phorton1/Arduino-tempController/docs/readme.md

# tempearature Controller

This is an ESP32 based Relay controller based on a **DS18B20** temperature
sensors.

## Please Also See

This project directly makes direct use of my
[**MyIOT**](https://github.com/phorton1/Arduino-libraries-myIOT)
("my internet of things*) repository, which provides a generalized approach to
building relatively simple parameter driven ESP32 devices that include a Web UI.

The PCBs (printed circuit boards) were **milled** using the
[**cnc3018**](https://github.com/phorton1/Arduino-esp32_cnc3018) CNC
machine that I built.

I hope you will take a few minutes to check out some of these other pages too!!

## Credits

This project directly relies upon the public open source Arduino development system,
the Espressif ESP32 online documentation and additions to the Arduino IDE, as
well as a number open source Arduino libraries

I would like to thank the countless individuals who have contributed to making these
development tools, source codes, and documentation available for free public use, including,
but not limited to:

- [KiCad](https://www.kicad.org/)
- [FlatCAM](https://bitbucket.org/jpcgt/flatcam/downloads/) by **Juan Pablo Caram**
- [Arduino IDE and Libraries](https://www.arduino.cc/)
- [Espressif Systems](https://www.espressif.com/en/products/socs/esp32)
- **jQuery**, **Bootstrap**, and the [jqPlot](Xhttp://www.jqplot.com/) javascript libraries

## License

This program, project, and repository is free software: you can redistribute it and/or modify
it under the terms of the GNU General Public License Version 3 as published by
the Free Software Foundation.

These materials are distributed in the hope that they will be useful,
but WITHOUT ANY WARRANTY; without even the implied warranty of
MERCHANTABILITY or FITNESS FOR ANY PARTICULAR PURPOSE.  See the
GNU General Public License for more details.

Please see [LICENSE.TXT](../LICENSE.TXT) for more information.
