phorton1/Arduino-tempController/docs/fusion/temp_box_top.stl

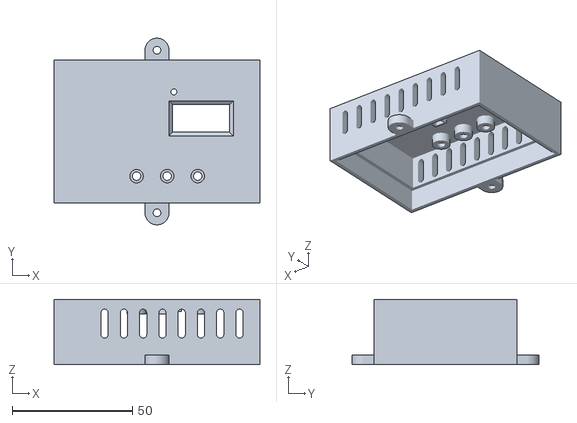
[picture p1: CAD file, 2024-12-26]
docs/fusion/temp_box_top.stl
85.5 x 77.5 x 27.0
