phorton1/Arduino-tempController/docs/fusion/temp_box_button_cap.stl

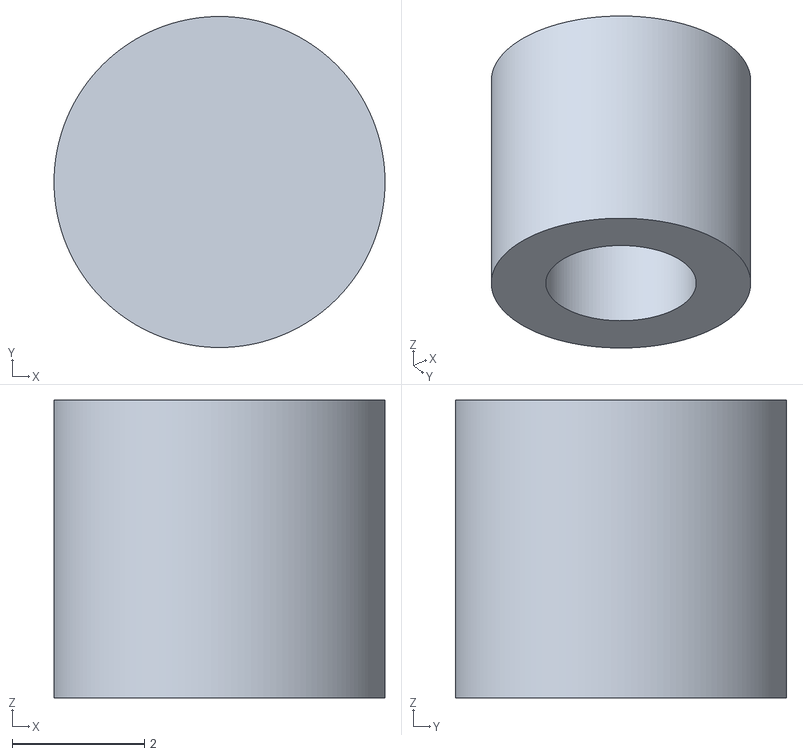
[picture p2: CAD file, 2024-12-26]
docs/fusion/temp_box_button_cap.stl
5.00 x 5.00 x 4.50
