phorton1/Arduino-tempController/docs/prusa/temp_box_button_caps.3mf

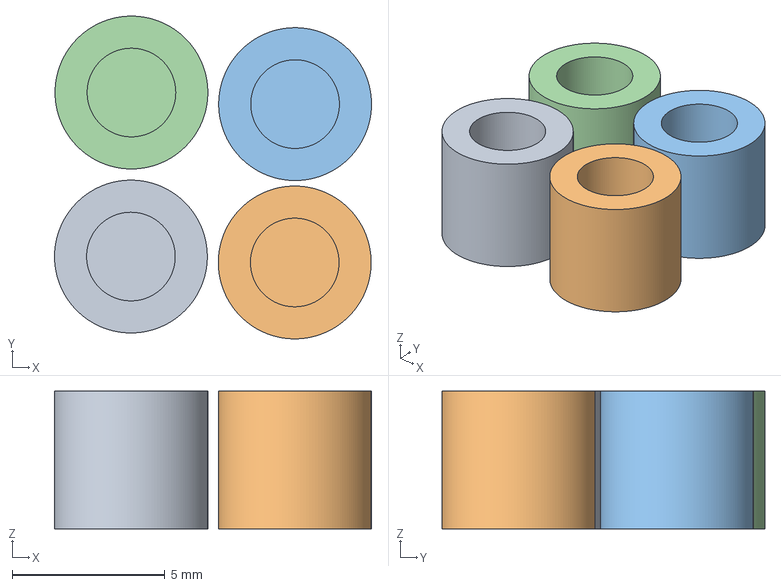
[picture p3: CAD file, 2024-12-26]
docs/prusa/temp_box_button_caps.3mf
10.4 x 10.6 x 4.50 mm
temp_box_button_cap.stl x 4
