phorton1/Arduino-tempController/docs/fusion/temp_box_base.stl

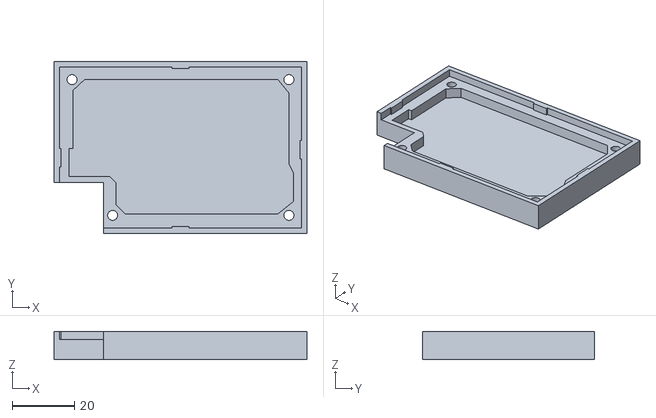
[picture p4: CAD file, 2024-12-26]
docs/fusion/temp_box_base.stl
81.1 x 55.1 x 9.00
