phorton1/Arduino-tempController/(list of files, cad)

Other CAD files:
docs/prusa/temp_box_top.3mf
docs/prusa/temp_box_base.3mf
docs/fusion/tempControllerBox.f3d
