phorton1/Arduino-tempController/docs/kicad/board/board.kicad_pcb

## KiCad design docs/kicad/board/board.kicad_pcb (2024-12-26)

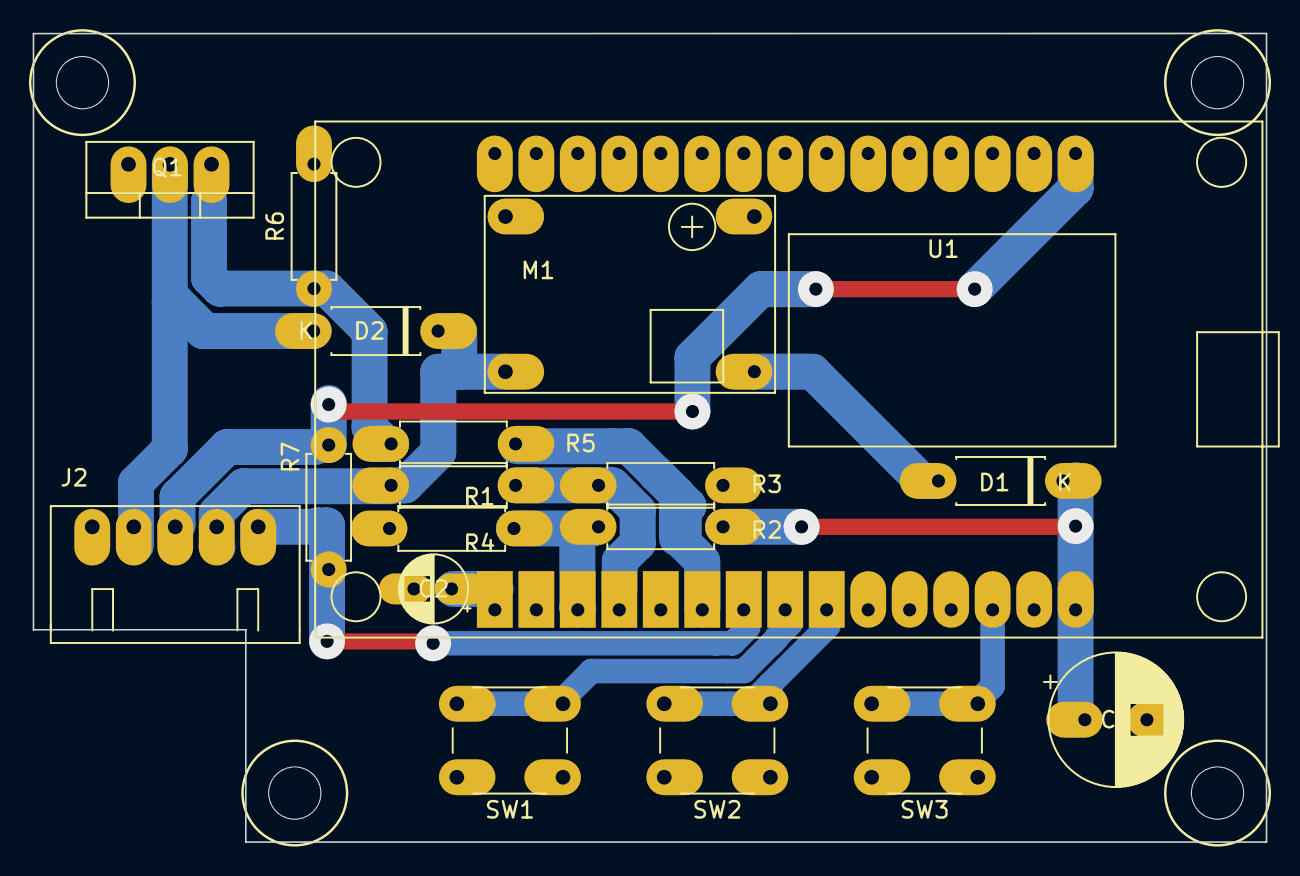
[picture p5: board board.kicad_pcb from above]

Board: 2 copper layers, 75.5 x 49.5 mm, 18 parts (0 on the bottom side), 15 nets.

Parts:
C1: 100uf; CP_my100uf
C2: 4.7uf; CP_my10uf
D1: 1N4005; myDiodeSchotsky
D2: 1N5818; myDiodeSchotsky
J2: Connector; myJST5_right
M1: BUCK01; buck-mini360
Q1: IRLZ44N; myThreeLeggedDown
R1: 10K; resistor
R2, R4, R7: 4.7K; resistor
R3: 2K; resistor
R5: 100; resistor
R6: 10K; myResistor
SW1: BUTTON1; button_6mm_H8
SW2: BUTTON2; button_6mm_H8
SW3: BUTTON3; button_6mm_H8
U1: ESP32_DEV_0; esp32_oled_small

Connections:
+3V3: J2.3, R7.2, U1.30
+5V: C1.1, D1.1, R2.2, U1.1
+12V: D2.1, J2.4, M1.4, R1.2
BUTTON1: SW1.2, U1.8
BUTTON2: SW2.2, U1.7
BUTTON3: SW3.2, U1.3
EN: C2.1, U1.15
FAN-: D2.2, J2.2, Q1.2
GND: C1.2, C2.2, J2.1, M1.1, M1.2, Q1.3, R3.1, R4.1, R6.2, SW1.1, SW2.1, SW3.1, U1.2, U1.29
unnamed: D1.2, M1.3
unnamed: Q1.1, R5.2, R6.1
ONE_WIRE: J2.5, R7.1, U1.9
RELAY: R5.1, U1.10
S_5V: R2.1, R4.2, U1.13
S_12V: R1.1, R3.2, U1.12
