phorton1/Arduino-tempController/docs/kicad/connector_pcb/connector_pcb.kicad_pcb

## KiCad design docs/kicad/connector_pcb/connector_pcb.kicad_pcb (2024-12-11)

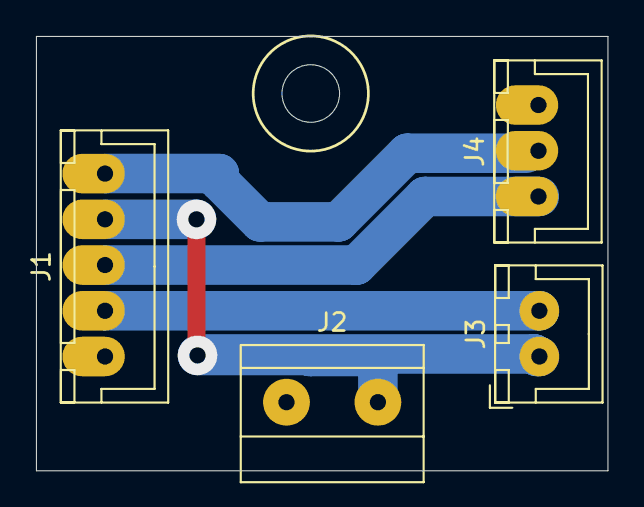
[picture p6: board connector_pcb.kicad_pcb from above]

Board: 2 copper layers, 31.8 x 24.1 mm, 4 parts (0 on the bottom side), 5 nets.

Parts:
J1: Connector; JST5
J2: POWER; myTerminalBlock_5.08x02
J3: FAN; myJSTx02
J4: TEMP; JST3

Connections:
+3V3: J1.3, J4.1
+12V: J1.4, J2.2, J3.1
FAN-: J1.2, J3.2
GND: J1.1, J2.1, J4.3
ONE_WIRE: J1.5, J4.2
