phorton1/Arduino-tempController/docs/kicad/board1/board1.kicad_pcb

## KiCad design docs/kicad/board1/board1.kicad_pcb (2024-10-21)

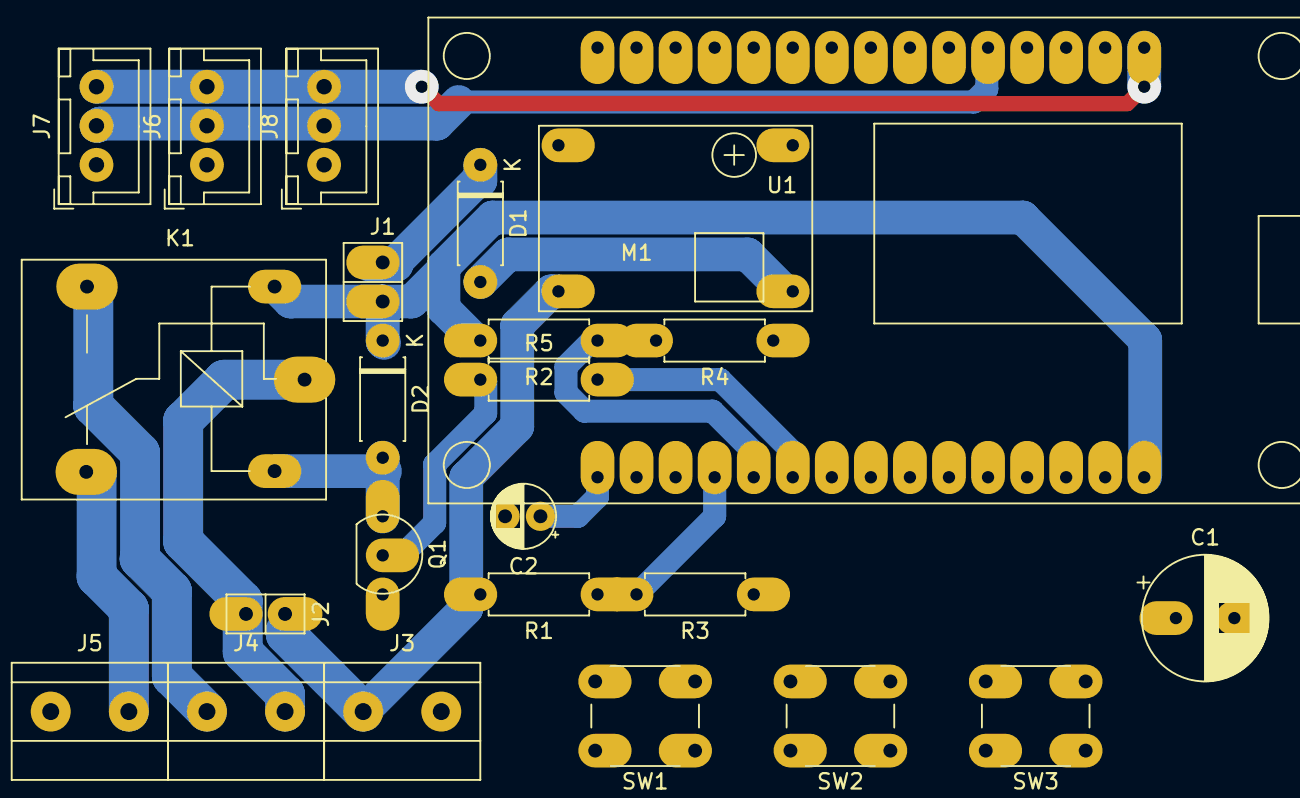
[picture p7: board board1.kicad_pcb from above]

Board: 2 copper layers, 24 parts (0 on the bottom side), 19 nets.

Parts:
C1: 100uf; CP_my100uf
C2: 4.7uf; CP_my10uf
D1, D2: 1N400x; myDiodeSchotsky
J1: 5V_JUMP; pinHeader1x2
J2: 12V; myPinHeader_1x02
J3: POWER; myTerminalBlock_5.08x02
J4: RELAY; myTerminalBlock_5.08x02
J5: DEVICE; myTerminalBlock_5.08x02
J6, J7, J8: Temp; myJSTx03
K1: myRelay; myRelay2
M1: BUCK01; buck-mini360
Q1: BCS547; transistor
R1, R2: 10K; resistor
R3: 2K; resistor
R4: 4.7K; resistor
R5: 1K; resistor
SW1: BUTTON1; button_6mm_H12
SW2: BUTTON2; button_6mm_H12
SW3: BUTTON3; button_6mm_H12
U1: ESP32_DEV_0; esp32_oled_small

Connections:
+3V3: J6.3, J7.3, J8.3, U1.30
+5V: C1.1, D2.1, J1.2, K1.2, R2.2, U1.1
+12V: J2.1, J3.1, M1.4, R1.2
BUTTON1: SW1.2, U1.5
BUTTON2: SW2.2, U1.4
BUTTON3: SW3.2, U1.3
COMMON: J2.2, J4.2, K1.3
GND: C1.2, C2.2, J3.2, J5.1, J6.1, J7.1, J8.1, M1.1, M1.2, Q1.3, R3.1, R4.1, SW1.1, SW2.1, SW3.1, U1.2, U1.29
NC: J5.2, K1.4
NO: J4.1, K1.5
unnamed: C2.1, U1.15
unnamed: D1.1, J1.1
unnamed: D1.2, M1.3
unnamed: D2.2, K1.1, Q1.1
unnamed: Q1.2, R5.1
ONE_WIRE: J6.2, J7.2, J8.2, U1.26
RELAY: R5.2, U1.10
S_5V: R2.1, R4.2, U1.11
S_12V: R1.1, R3.2, U1.12
