phorton1/Arduino-tempController/controller.h

//----------------------------------------------
// constants for temperature controller
//----------------------------------------------
// Embedded SSD1306 display uses ESP32 standard I2C scl(22) sda(21)

#pragma once

#include <myIOTDevice.h>

#define WITH_ONBOARD_LED	1
	// shows blue if !wifi STATION


//=========================================================
// pins
//=========================================================

#define PIN_ONBOARD_LED		2
#define PIN_ONE_WIRE		33		// One-Wire bus to DS18B20 temperature probes

#define PIN_BUTTON1			25
#define PIN_BUTTON2			26
#define PIN_BUTTON3			13

#define PIN_S_12V			34		// sense 12V
#define PIN_S_5V			39		// sense buck 5V power supply

#define PIN_RELAY			32		// Actually, a MOSFET turns FAN on


//------------------------
// myIOT definition
//------------------------

#define TEMP_CONTROLLER			"tempController"
#define TEMP_CONTROLLER_VERSION	"tc0.1"
#define TEMP_CONTROLLER_URL		"https://github.com/phorton1/Arduino-boat-tempController"

#define BACKLIGHT_ALWAYS_ON			120

#define MIN_SETPOINT_DIF	2.0		// centigrade


#define TEMP_MODE_OFF			0
#define TEMP_MODE_ON_HIGH		1
#define TEMP_MODE_ON_LOW		2
#define TEMP_MODE_FORCE			3


#define ID_MODE						"MODE"
#define ID_SETPOINT_HIGH            "SETPOINT_HIGH"
#define ID_SETPOINT_LOW             "SETPOINT_LOW"
#define ID_TEMP_SENSE_ID            "TEMP_SENSE_ID"
#define ID_SENSE_SECS          		"SENSE_SECS"
#define ID_CALIB_VOLTS_12V          "CALIB_VOLTS_12V"
#define ID_CALIB_VOLTS_5V           "CALIB_VOLTS_5V"
#define ID_BACKLIGHT_SECS			"BACKLIGHT_SECS"

#define ID_STATUS					"STATUS"
#define ID_TEMPERATURE              "TEMPERATURE"
#define ID_RELAY_ON					"RELAY_ON"
#define ID_VOLTS_12V				"VOLTS_12V"
#define ID_VOLTS_5V					"VOLTS_5V"
#define ID_CHART_LINK				"CHART"



extern enumValue tempModes[];
	// in tempController.ino


class tempController : public myIOTDevice
{
public:

    tempController();
    ~tempController() {}

    virtual void setup() override;
    virtual void loop() override;

    // config values

	static int 		_mode;
	static float	_setpoint_high;
	static float	_setpoint_low;
	static String	_temp_sense_id;
	static int		_sense_secs;
	static float	_calib_volts_12v;
	static float	_calib_volts_5v;
	static int		_backlight_secs;

	// state values

	static String	_status_str;
	static float	_temperature;
	static bool		_relay_on;
	static float	_volts_12v;
	static float	_volts_5v;
	static String 	_chart_link;

	// public states available to other objects

	static int 		m_temp_error;	// low level error getting temperature

	// methods

	void setRelay(bool on);

	void stateMachine();
	static void stateTask(void *param);
	static void onSetPointChanged(const myIOTValue *value, float val);
	static void onBacklightChanged(const myIOTValue *value, int val);

	// extensions
	
	String onCustomLink(const String &path,  const char **mime_type) override;

};


extern tempController *controller;
