phorton1/Arduino-tempController/(commit log)

2024-10-19 add Arduino-tempController to github
2024-10-21 move generic uiButtons to myIOTButtons; implement initial tempController uiScreen and PCB board(s)
    [board1.kicad_pcb, board1.sch, board2.kicad_pcb, board2.sch]
2024-10-21 submodule(data) auto_commit(b811e3f8) move generic uiButtons to myIOTButtons; implement initial tempController uiScreen and PCB board(s)
2024-10-22 initial build Controller PCB & Box - forgot ONE_WIRE pullup, changed to 100ohm RELAY resistor, temp removed fan flyback diode
    [board3.kicad_pcb, board3.sch, tempControllerBox.f3d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]
2024-10-23 Power ideaSpark board via 3.3V line instead of VIN
    [board3.kicad_pcb, board3.sch]
2024-10-24 rework OLED UI; added Voltage sensing; comments and code prettiness
    [controller.cpp, controller.h, tempController.ino, tempVolts.h, uiScreen.cpp, uiScreen.h]
2024-10-24 normalized fridgeController to use myIOT Temperature sensor and Buttons; rename objects in fridgeController and tempController for consistency and name space separation.
2024-10-25 reprint tempControllerBox top
    [tempControllerBox.f3d, temp_box_top.3mf, temp_box_top.stl]
2024-10-30 chnage Arduino-libraries-myIOT/myTempSensor to myIOTTempSensor to allow for a "my" version that is currently not on github
2024-12-11 design, print, and solder pcb_connector for Rhapsody tempController installation
    [board3.sch, connector_pcb.kicad_pcb, connector_pcb.sch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]
2024-12-26 rebuild tempController box & pcb - back to 5V power supply
    [board.kicad_pcb, board.sch, tempControllerBox.f3d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]
2024-12-26 back to 5V (DIN) buck power supply
2025-12-15 fixed minor typo (don't know how it compiled) in controller.cpp history circular buffer code
    [controller.cpp]
2025-12-15 submodule(data) auto_commit(b649fc3a) iotChart.js - added scheme for setting device specific series colors
2025-12-18 submodule(data) auto_commit(1adaeb45) reworked iotChart.js incremental update scheme starting with Arduino-boat-drainPump
2025-12-18 submodule(data) auto_commit(b6ac0c88) starting in Arduino-boat-arirco, major rework of iotChart.js and how charts are implemented - use common chart.html instead of specific/extra_data/device_chart.h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
2025-12-18 submodule(data) auto_commit(a4e2ed81) change chart.html and iotChart.js to use and remove style "degree_hidden" for devices that chart things with degrees
2026-02-22 myIOTHTTP.cpp: added special case to do token replacement for "data_name" in chart.html AND updated myIOT devices with charts to pass data_name in chart_link
    [controller.cpp]
2026-02-22 submodule(data) auto_commit(37a6a76c) added framework for chart.html to pass "data_name" to allow multiple charts per device; ALSO store most recent chart period in browser storage
2026-03-05 added "boat" to the myIOTDevice advertised SSDP device URL
2026-03-05 submodule(data) auto_commit(ecc76888) update myIOT data submodule readme.md to remove forward references to actual implmented device repos
2026-06-28 submodule(data) auto_commit(eadab9ea) added myIOTDataLog type LOG_COL_TYPE_INT16_10 to support volts (fridgeController)
